RichardSmetana/epaper433/epaper433_logo.h

#ifndef EPAPER433_LOGO_H
#define EPAPER433_LOGO_H

#include <Arduino.h>

// Monochrome bitmap for splash (1 bit = black). Drawn with Adafruit_GFX drawBitmap.
#define EPAPER433_LOGO_WIDTH 250
#define EPAPER433_LOGO_HEIGHT 122

// -------------------------------------------------------------------------
// ANLEITUNG ZUM EINFÜGEN DER BILDDATEN:
// 1. Speichere das generierte Bild ab.
// 2. Öffne https://javl.github.io/image2cpp/
// 3. Wähle das Bild aus.
// 4. Setze "Canvas size" auf 212 x 104.
// 5. Bei "Output" wähle "Arduino code", Mode "Horizontal, 1 bit per pixel".
// 6. Klicke "Generate" und kopiere die Hex-Werte hier hinein:
// -------------------------------------------------------------------------

const uint8_t epaper433_logo[] PROGMEM = {
  // ... füge hier die von image2cpp generierten Hex-Werte ein ...
  	0x00, 0x07, 0xff, 0xff, 0xff, 0xff, 0xff, 0xff, 0xff, 0xff, 0xff, 0xff, 0xff, 0xff, 0xff, 0xff, 
	0xff, 0xff, 0xff, 0xff, 0xff, 0xff, 0xff, 0xff, 0xff, 0xff, 0xff, 0xff, 0xff, 0xf8, 0x00, 0x00, 
	0x00, 0x3f, 0xff, 0xff, 0xff, 0xff, 0xff, 0xff, 0xff, 0xff, 0xff, 0xff, 0xff, 0xff, 0xff, 0xff, 
	0xff, 0xff, 0xff, 0xff, 0xff, 0xff, 0xff, 0xff, 0xff, 0xff, 0xff, 0xff, 0xff, 0xff, 0x00, 0x00, 
	0x01, 0xff, 0xff, 0xff, 0xff, 0xff, 0xff, 0xff, 0xff, 0xff, 0xff, 0xff, 0xff, 0xff, 0xff, 0xff, 
	0xff, 0xff, 0xff, 0xff, 0xff, 0xff, 0xff, 0xff, 0xff, 0xff, 0xff, 0xff, 0xff, 0xff, 0xe0, 0x00, 
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
	0xfc, 0x00, 0x00, 0x3f, 0xc0, 0x0f, 0xe0, 0x00, 0x00, 0x00, 0x00, 0x00, 0x00, 0x00, 0x00, 0x00, 
	0x07, 0xf8, 0x00, 0x00, 0x01, 0xfe, 0x00, 0x00, 0x00, 0x00, 0x00, 0x00, 0x00, 0x00, 0x0f, 0xc0, 
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
};

#endif
