RichardSmetana/epaper433/LowPowerSleep.h

#ifndef LOW_POWER_SLEEP_H
#define LOW_POWER_SLEEP_H

#include <Arduino.h>

typedef void (*LowPowerHookFn)();

void lowPowerSleepMs(uint32_t ms, LowPowerHookFn beforeSleep = nullptr, LowPowerHookFn afterWake = nullptr);
/** Release gpio_hold from previous deep sleep — call first in setup(). */
void lowPowerReleaseGpioHold();
void lowPowerButtonBegin();
bool lowPowerWokeFromButton();

#endif
